MrKevinWeiss/Testing/(threads)

Thread 3 (2018-06-11):

Maybe a problem withBPT slave I2C read with NO-STOP

MrKevinWeiss, 2018-06-11:
It appears that the BPT holds down the clock for the last bit or two when a stop is not called after a proper read.  This holds down the line making the master device seem to not be able to come out of an i2c busy state.  On the ISL29125 it doesn't seem to happen and can recover but I am not sure if that is because a timeout/recovery is implemented for that sensor only.  Further investigation is required.

MrKevinWeiss, 2018-06-26:
I tested on the ISL29125 again and it appears to be the same at the BPT.  Basically the bus cannot perform a no stop read then a repeated start, this may be because in order to send a start after a no stop, the scl line must go from low to high then back down to low.  This would make the slave think it is just clocking out more data.  In fact in the next byte is 0 it locks but if it is 0xFF it can clock out (since the SCL is not being held down).

Closed 2018-06-26.

Thread 8 (2018-06-19):

bpt_if: enable Python 3 support

yegorich, 2018-06-19:
```
Traceback (most recent call last):
  File "bpt_if_test.py", line 19, in <module>
    bpt.execute_changes()
  File "/usr/local/src/Testing/bpt_interface/base_if.py", line 130, in execute_changes
    return self.send_cmd(self.__EXECUTE_CMD)
  File "/usr/local/src/Testing/bpt_interface/base_if.py", line 46, in send_cmd
    self.__dev.write(send_cmd + '\n')
  File "/usr/lib/python3/dist-packages/serial/serialposix.py", line 518, in write
    d = to_bytes(data)
  File "/usr/lib/python3/dist-packages/serial/serialutil.py", line 63, in to_bytes
    raise TypeError('unicode strings are not supported, please encode to bytes: {!r}'.format(seq))
TypeError: unicode strings are not supported, please encode to bytes: 'ex\n'
```

MrKevinWeiss, 2018-06-19:
Hmmm, ya I should switch to python 3, nice catch!

MrKevinWeiss, 2018-06-22:
I think I fixed it, I will test with both python 3 and 2 now, Thanks.

Closed 2018-06-22.

Thread 9 (2018-06-19):

Add USB to Serial Stack

MrKevinWeiss, 2018-06-19:
I think I would like to add USB support to the BPT.  This would remove the requirement for wiring up a external usb to serial converter making it easier for people to adapt.  This would require a change in pinout.

Changes:
- SPI2 (PB12-PB15) -> SPI1 (PB3-PB5 & PA15) this means no jtag interface but since it uses swd it should be fine
- UART1 (PA9-PA12) -> UART3 (PB11, PB10, PB13, PB14)
- +USB (PA11, PA12)
- -UART2 (PA2,PA3)

To think about:
- Interrupt priority issues with USB
- Overhead in complexity, cpu usage and code size
- Opens up two more timers (PA9, PA10)
- Would we need to get a USB Vendor licence
- Customization of usb name (so it can be easily identified)

smlng, 2018-06-19:
Please consider the following:

- USART1 can be used for flashing, will this still be possible with these changes?
- can we have both? Serial via UART with wires AND using USB, that would be very convenient.

Otherwise, yes USB would ease deployment.

MrKevinWeiss, 2018-06-19:
Currently USART1 is used as the DUT test, this would free up the RX and TX of USART1 (but one could just unplug from the DUT if they want to use the ROM bootloader).  I think using the ROM bootloader would be achievable regardless (as long as the modem support isn't used for it).

Yes we can have both but I don't know why, every use can seems like it can have USB (RPi or computer) I don't think an MCU should have access to the config registers.  This would also add some complexity in terms of concurrency.  I would prefer to see the UART interface tot he config registers gone and only done through USB.

My worry is the interrupt priority, with the UART the priority is low but with the USB it may need to be higher so things don't timeout, if that is the case it may effect jitter and timings of things during the test.  The only thing that would calm that fear is that only one thing should communicate at a time.  maybe a keep alive signal might cause some issues but I am not too sure about the USB protocol and what is handled by the hardware.

An example of what I am talking about is the i2c clk stretch delay test, this stays in the interrupt for up to 16ms I think, if it is blocking USB signal then it may be a problem.  On the other hand if the USB is higher priority then when the I2C recognizes the address it may not be able to load in the data if it is stuck waiting for the USB to finish (which could either cause an unwanted clk stretch or sending incorrect data is clk stretch is disabled).

Maybe I am overthinking it though and just need to try it out.

MrKevinWeiss, 2018-07-20:
Seems to be functional just has some bugs that will be listed in other issues.

Closed 2018-07-20.

Thread 14 (2018-06-28):

bpt: Add automated way to track firmware revision in BPT

MrKevinWeiss, 2018-06-28:
This can be done with a hash on the binary, that would be best.  We need some way to ensure traceability so testing will always know what firmware it is using to test with.

MrKevinWeiss, 2018-09-19:
The binary contains build time.  FW revision should be handled manually as part of the release procedure.

Closed 2018-09-19.

Thread 35 (2018-07-20):

bpt: USB does not initialize after reset.

MrKevinWeiss, 2018-07-20:
If the USB is not plugged in the device never can initialize.  It seems like there must be a way to get the host cpu to request the initialization procedure again, maybe by powering off the USB module and switching it back on.  Currently to get USB communication the bpt must be plugged in, if communication is list it will need to be plugged in again.

MrKevinWeiss, 2018-09-18:
May be due to improper resistor in bluepill

MrKevinWeiss, 2019-01-03:
Closing since the USB functionality isn't really useful now that the nucleo is ported.

Closed 2019-01-03.

Thread 36 (2018-07-20):

bpt: TODO I2C improvments

MrKevinWeiss, 2018-07-20:
- [ ] Add 16 bit register support
- [ ] Add last read/write count
- [ ] Support nack injection
- [ ] 10 bit address support
- [ ] Improve portability
- [ ] Update commenting and documentation
- [ ] Remove blocking clk_stretch
- [ ] Add status register
- [ ] Add repeated start read sensing
- [ ] Add clock speed estimation
- [ ] Add error/status reg

MrKevinWeiss, 2018-09-19:
moving to https://github.com/riot-appstore/PHiLIP/issues/3

Closed 2018-09-19.
