MrKevinWeiss/Testing/BPH-1A/bph.PDF

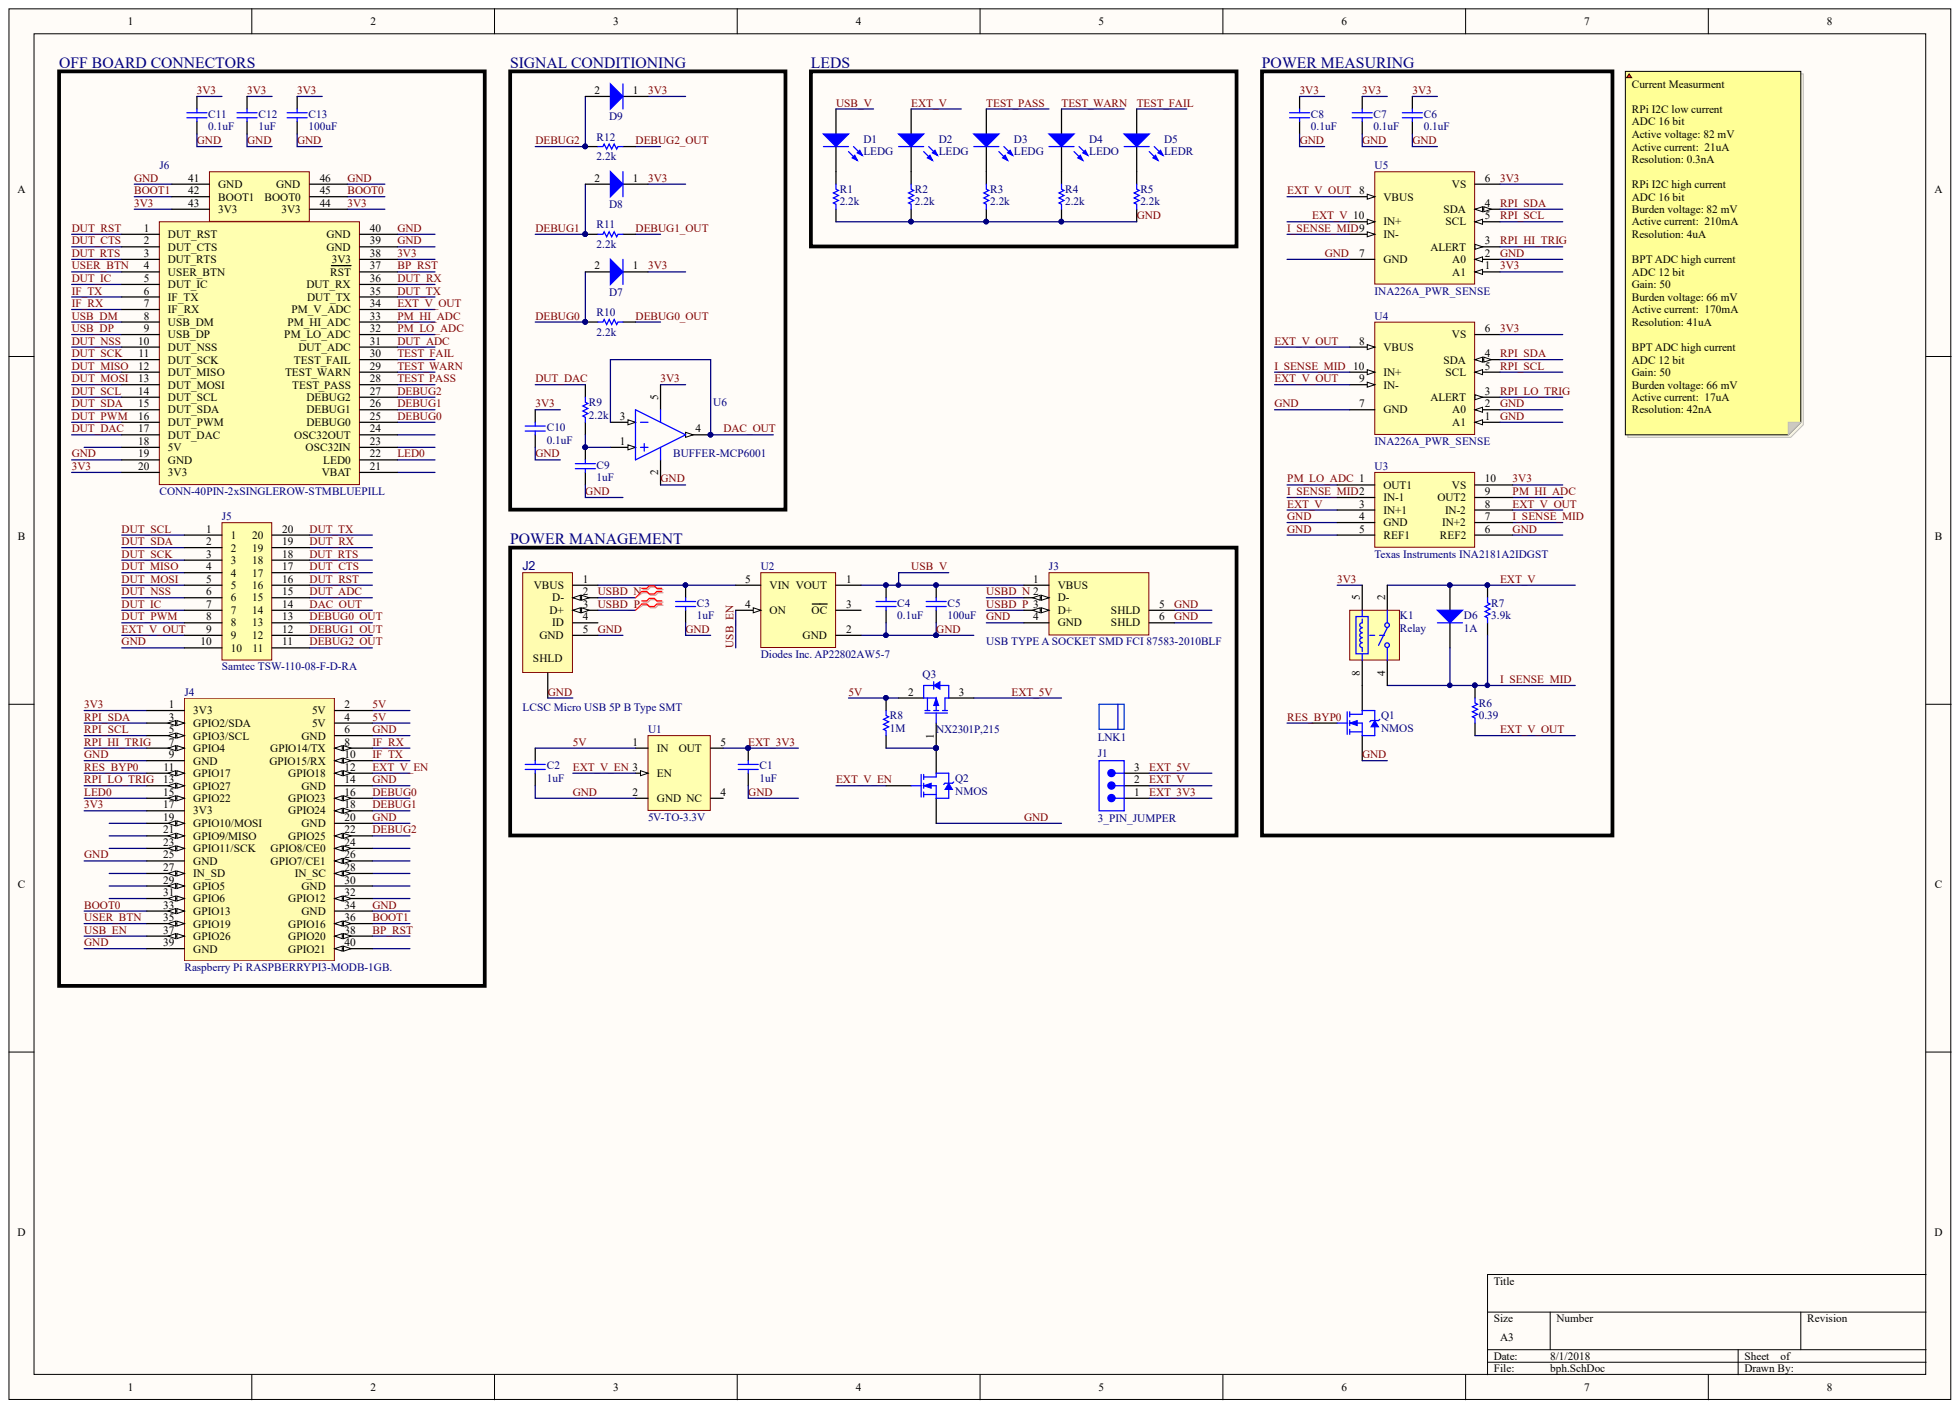
[picture p7: page 1]

BPT ADC high current
ADC 12 bit
Gain: 50
Burden voltage: 66 mV
Active current: 170mA
Resolution: 41uA

Active current: 17uA
Resolution: 42nA

USB TYPE A SOCKET SMD FCI 87583-2010BLF

GND
LCSC Micro USB 5P B Type SMT

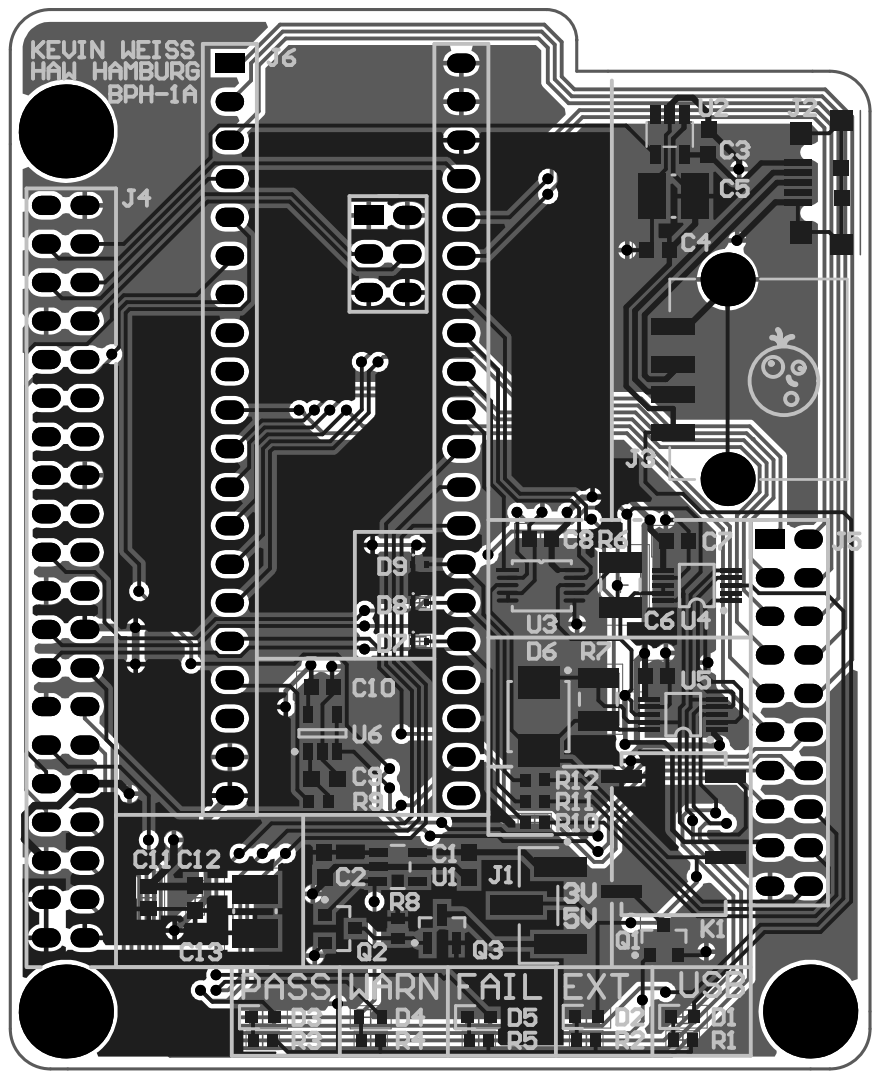
[picture p8: page 2]

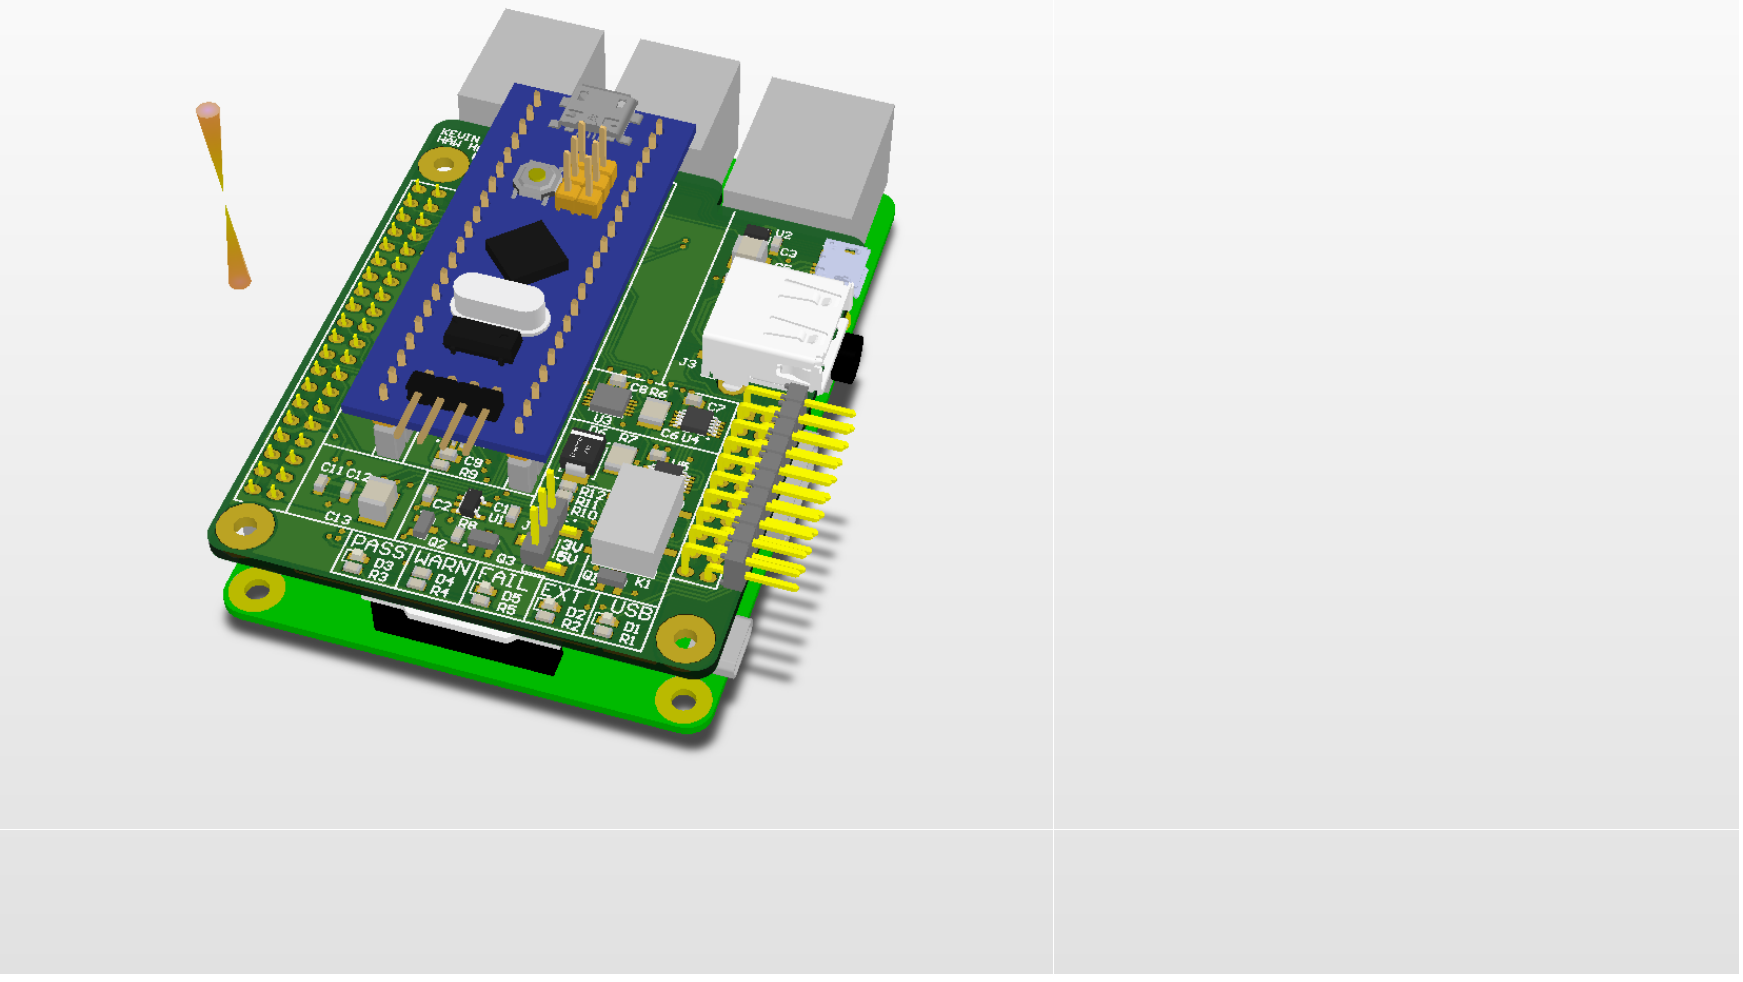
[picture p9: page 3]

# Electrical Rules Check Report

Class | Document | Message Successful Compile for bph.PrjPcb
Wednesday 1 Aug 2018 1:57:22 PM | Page 1 of 1

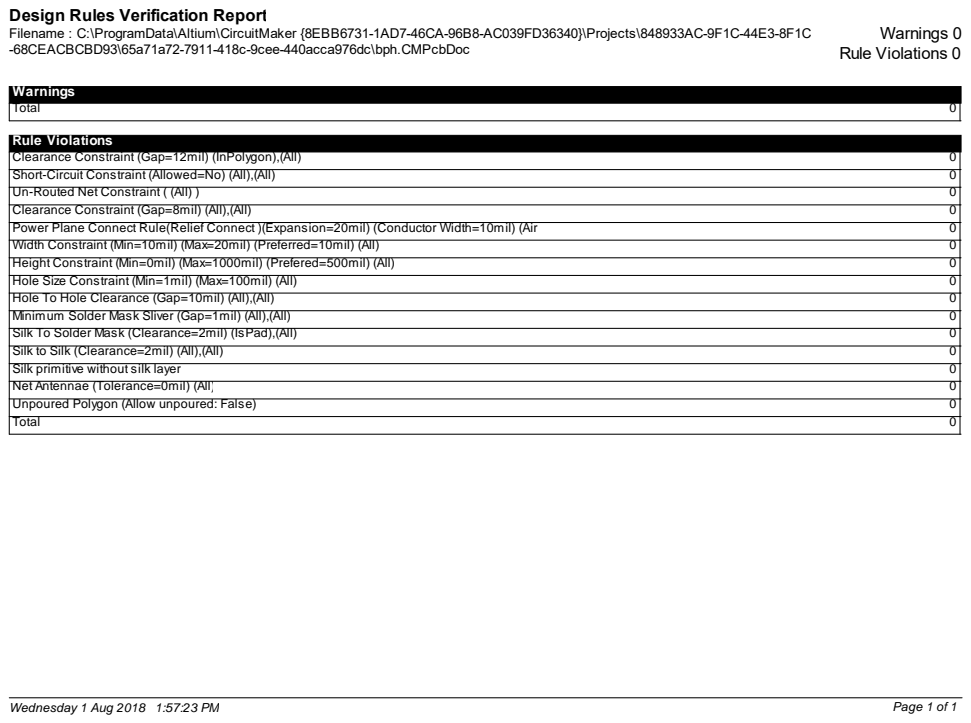
[picture p10: page 5]
Warnings 0 Rule Violations 0; Rule Violations; Clearance Constraint (Gap=12mil) (InPolygon),(All); Short-Circuit Constraint (Allowed=No) (All),(All); Un-Routed Net Constraint ( (All) ); Clearance Constraint (Gap=8mil) (All),(All); Power Plane Connect Rule(Relief Connect )(Expansion=20mil) (Conductor Width=10mil) (Air; Width Constraint (Min=10mil) (Max=20mil) (Preferred=10mil) (All); Height Constraint (Min=0mil) (Max=1000mil) (Prefered=500mil) (All)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

Design Rules Verification Report
Filename : C:\ProgramData\Altium\CircuitMaker {8EBB6731-1AD7-46CA-96B8-AC039FD36340}\Projects\848933AC-9F1C-44E3-8F1C
-68CEACBCBD93\65a71a72-7911-418c-9cee-440acca976dc\bph.CMPcbDoc
