MrKevinWeiss/Testing/bluepill_tester/stmcube_generation/nucleoPort.ioc

Mcu.UserName=STM32F103RBTx
PA0-WKUP.GPIO_Label=TEST_WARN
PA0-WKUP.Signal=GPIO_Output
PA1.GPIO_Label=TEST_FAIL
PA1.Signal=GPIO_Output
PA10.GPIO_Label=DUT_RX
PA10.Signal=USART1_RX
PA11.GPIO_Label=DUT_CTS
PA11.Signal=GPXTI11
PA12.GPIO_Label=DUT_RTS
PA12.Signal=GPIO_Output
PA13.GPIO_Label=TMS
PA13.Signal=SYS_JTMS-SWDIO
PA14.GPIO_Label=TCK
PA14.Signal=SYS_JTCK-SWCLK
PA2.GPIO_Label=IF_TX
PA2.Signal=USART2_TX
PA3.GPIO_Label=IF_RX
PA3.Signal=USART2_RX
PA4.GPIO_Label=TEST_PASS
PA4.Signal=GPIO_Output
PA5.GPIO_Label=LED0
PA5.Signal=GPIO_Output
PA8.GPIO_Label=DUT_IC
PA8.Signal=S_TIM1_CH1
PA9.GPIO_Label=DUT_TX
PA9.Signal=USART1_TX
PB0.GPIO_Label=DUT_ADC
PB0.Signal=ADCx_IN8
PB12.GPIO_Label=DUT_NSS
PB12.Signal=SPI2_NSS
PB13.GPIO_Label=DUT_SCK
PB13.Signal=SPI2_SCK
PB14.GPIO_Label=DUT_MISO
PB14.Signal=SPI2_MISO
PB15.GPIO_Label=DUT_MOSI
PB15.Signal=SPI2_MOSI
PB2.GPIO_Label=DUT_RST
PB2.Signal=GPIO_Output
PB3.GPIO_Label=DEBUG0
PB3.Signal=GPIO_Output
PB4.GPIO_Label=DEBUG1
PB4.Signal=GPIO_Output
PB5.GPIO_Label=DEBUG2
PB5.Signal=GPIO_Output
PB8.GPIO_Label=DUT_SCL
PB8.Signal=I2C1_SCL
PB9.GPIO_Label=DUT_SDA
PB9.Signal=I2C1_SDA
PC0.GPIO_Label=PM_V_ADC
PC0.Signal=ADCx_IN10
PC1.GPIO_Label=PM_LO_ADC
PC1.Signal=ADCx_IN11
PC13-TAMPER-RTC.GPIO_Label=USER_BTN
PC13-TAMPER-RTC.Signal=GPIO_Input
PC14-OSC32_IN.Signal=RCC_OSC32_IN
PC15-OSC32_OUT.Signal=RCC_OSC32_OUT
PC2.GPIO_Label=PM_HI_ADC
PC2.Signal=ADCx_IN12
PC8.GPIO_Label=DUT_PWM
PC8.Signal=S_TIM3_CH3
PC9.GPIO_Label=DUT_DAC
PC9.Signal=S_TIM3_CH4
PD0-OSC_IN.Signal=RCC_OSC_IN
PD1-OSC_OUT.Signal=RCC_OSC_OUT
