MrKevinWeiss/Testing/(commit log)

2018-04-20 Add bluepill setup and command table
    [KinteBoard Debug.cfg, periph-test-command-table.csv]
2018-05-11 KinteBoard: WIP still testing things
    [KinteBoardMemMap.csv, periph-test-command-table.csv]
2018-05-13 kinteboard: problem compiling, checking previous states
    [main.c]
2018-05-15 WIP clean app_com bluepill tester
    [bluepill_tester Debug.cfg]
2018-05-16 WIP i2c and serial com work
2018-05-17 remove KinteBoard
    [KinteBoard Debug.cfg]
2018-05-17 add BPT.csv
    [BPT.csv]
2018-05-17 remove unused kinteboard csv
    [KinteBoardMemMap.csv]
2018-05-17 make i2c/serial com and register play well
2018-05-18 Fix typedef and add some i2c config, not tested
    [main.c]
2018-05-18 Fix clk stretch support
    [main.c]
2018-05-18 WIP fail when timeout I2C, delay broken, fixed some shell, before heading home
    [main.c]
2018-05-19 WIP: fix i2c timeout, i2c clk stretch delay, change tx nline to \n, add debug message
2018-05-22 Update BPT.csv second round
    [BPT.csv]
2018-05-28 Add device num and fix fw rev placement
2018-05-30 silly mistakes in i2c, todo and interface fix
2018-06-13 Update README.md
    fix I2C data pin naming SCK -> SDA
2018-06-17 uart test: add initial support
2018-06-18 Fix include and update doc
    [main.c]
2018-06-19 Eclipse: don't track generated files in git and move them to .gitignore
    [bluepill_tester Debug.cfg]
2018-06-19 typedef-gen: added interface support with tests
    [BPT.csv, bpt_mem_map.csv]
2018-06-20 usb: Also support uart protocol on uart1 since usb is a bit of a pain
2018-06-21 mem_map: Update mem map for access and dut_rst pin
    [bpt_mem_map.csv]
2018-06-22 Fix interface for bpt, add reset dut
    [base_if.py]
2018-06-22 Major stucture change and cleanup
    [bpt_mem_map.csv]
2018-06-29 doc: Updated slave board specification
    [bpt_mem_map.csv]
2018-06-29 app_uart: test script improvements
    * set baudrate explicitly to 115200
    * add wrong baudrate test
    * add dutport parameter specifying serial port connected to BP's UART3
    [uart_prot_test.py]
2018-07-04 Fix header file includes after renaming serial_com to app_shell_if
    [main.c]
2018-07-12 Add UART control structure to the bpt.json
    Refresh app_typedef.h and change uart_ctrl field to ctrl.
2018-07-13 Adapt USB interface to the new uart_port structure
    Add mode and invoke parse_input instead of parse_command.
2018-07-16 Add Rx/Tx counters
    Remove obsolete structure members and introduce rx_count and tx_count.
    Print both counters at the end of all positive tests.
2018-07-19 bpt: Add configurations for bpt/nucleo
    [RELEASE-BPT.cfg, RELEASE-NUCLEO-F103RB.cfg]
2018-07-20 Add RTS pin to UARTs control structure
2018-07-20 code_gen: Update mem map to support i2c improvments
2018-07-20 UART: add a test for DUT's CTS signal
2018-07-25 Introduce transmit mode
    Resolves issue #38.
    [bpt_mem_map.py, uart_prot_test.py]
2018-08-01 bph: Initial hardware board add
    [BOM_PartType-bph.csv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]
2018-08-01 bph: Updated file format
    [BOM_PartType-bph.csv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]
2018-08-06 UART: setup pull-down option for CTS pin
    CTS pin is setup to generate an interrupt on the rising edge, so
    setup pull-down option in order to prevent unwanted interrupts in
    unconnected case.
2018-08-21 htr/nucleo: Fix i2c config in nucleo
2018-08-21 Use Robot Framework for qualification tests
    Introduce TestUartDevice.py a wrapper for Robot Framework, that
    covers testing UART operations like configuration, reading and
    writing.
    Implemented tests:
    * Echo Test
    * Extended Echo Test
    * Register Access Test
    * Even Parity Test
    * Odd Parity Test
    * Wrong Parity Test
    * Two Stop Bits Test
    * RTS On Test
    * RTS Off Test
    * CTS Test
    [TestUartDevice.py]
2018-08-22 stmcube/nucleo: Update stmcube files for nucleo set rst pin
